IslamHUFE/ECG/circuits/ECG R-puls detector circuit.pdf

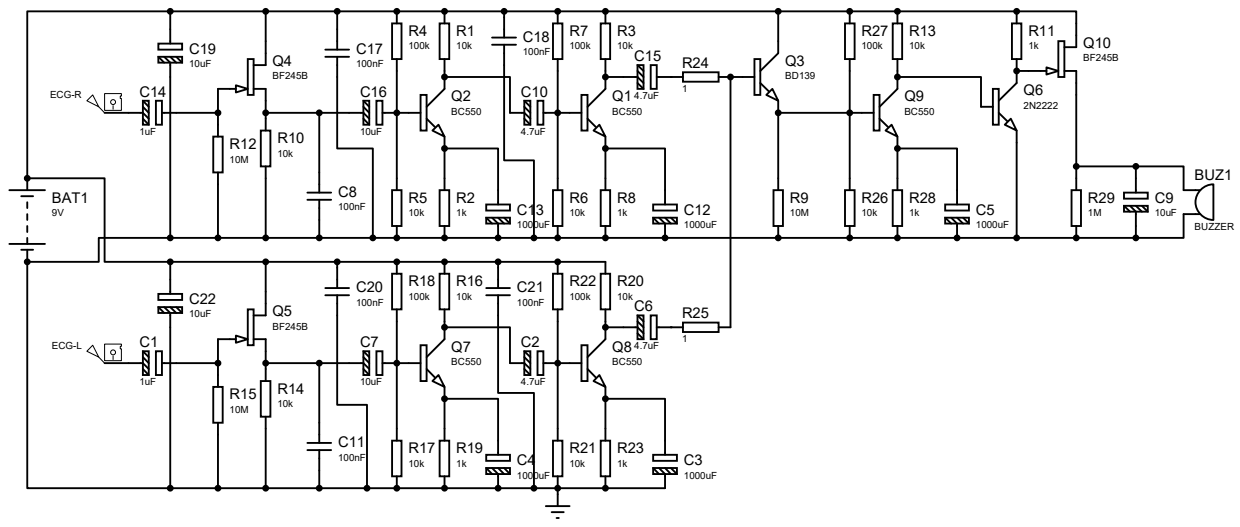
[picture p8: page 1]
