IslamHUFE/ECG/circuits/ECG R-pulse detector circuit 2.pdf

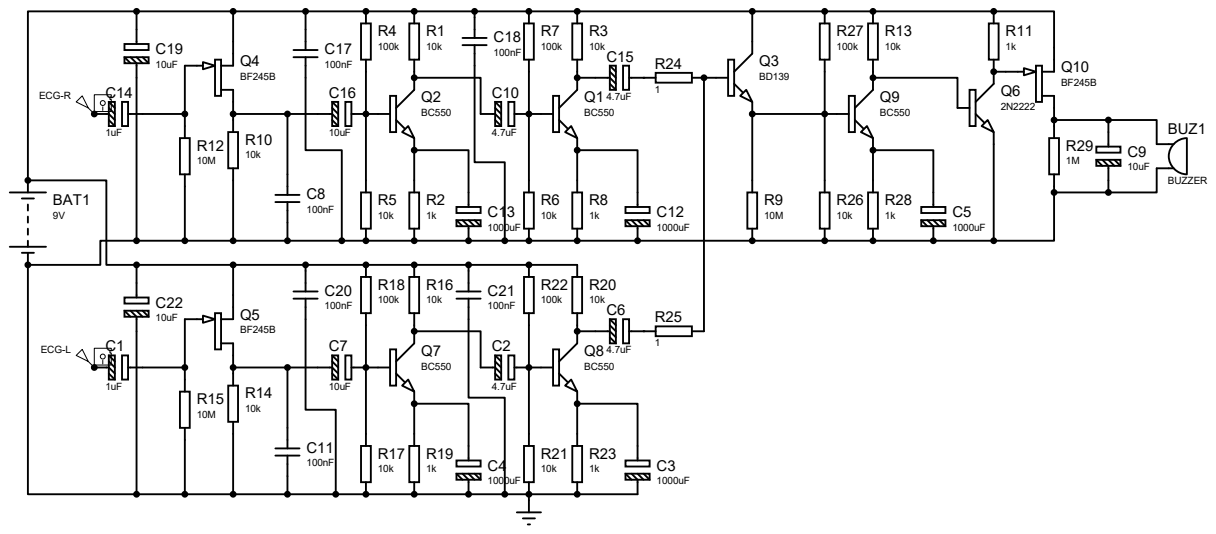
[picture p9: page 1]
