IslamHUFE/ECG/circuits/ؤهقؤعهف.pdf

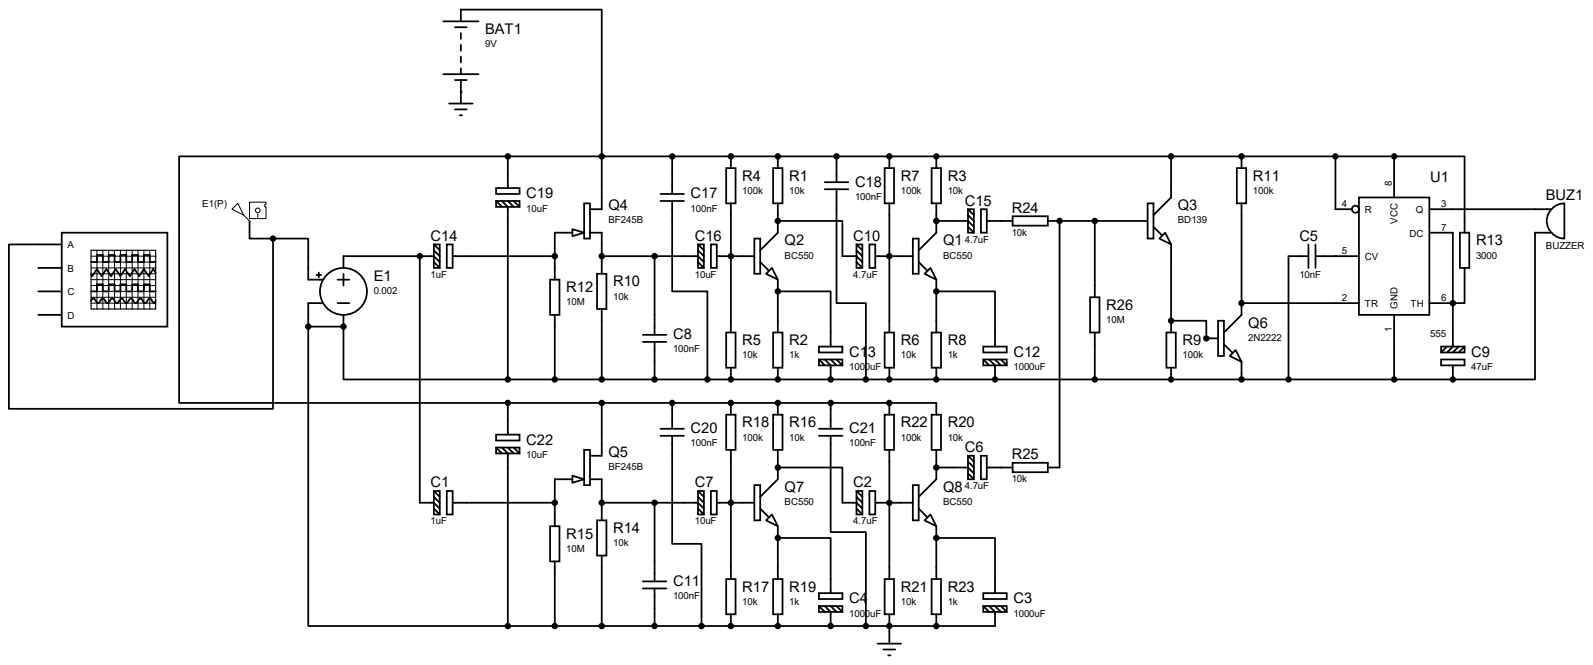
[picture p10: page 1]
