IslamHUFE/ECG/DATA/Freq 1.PDF

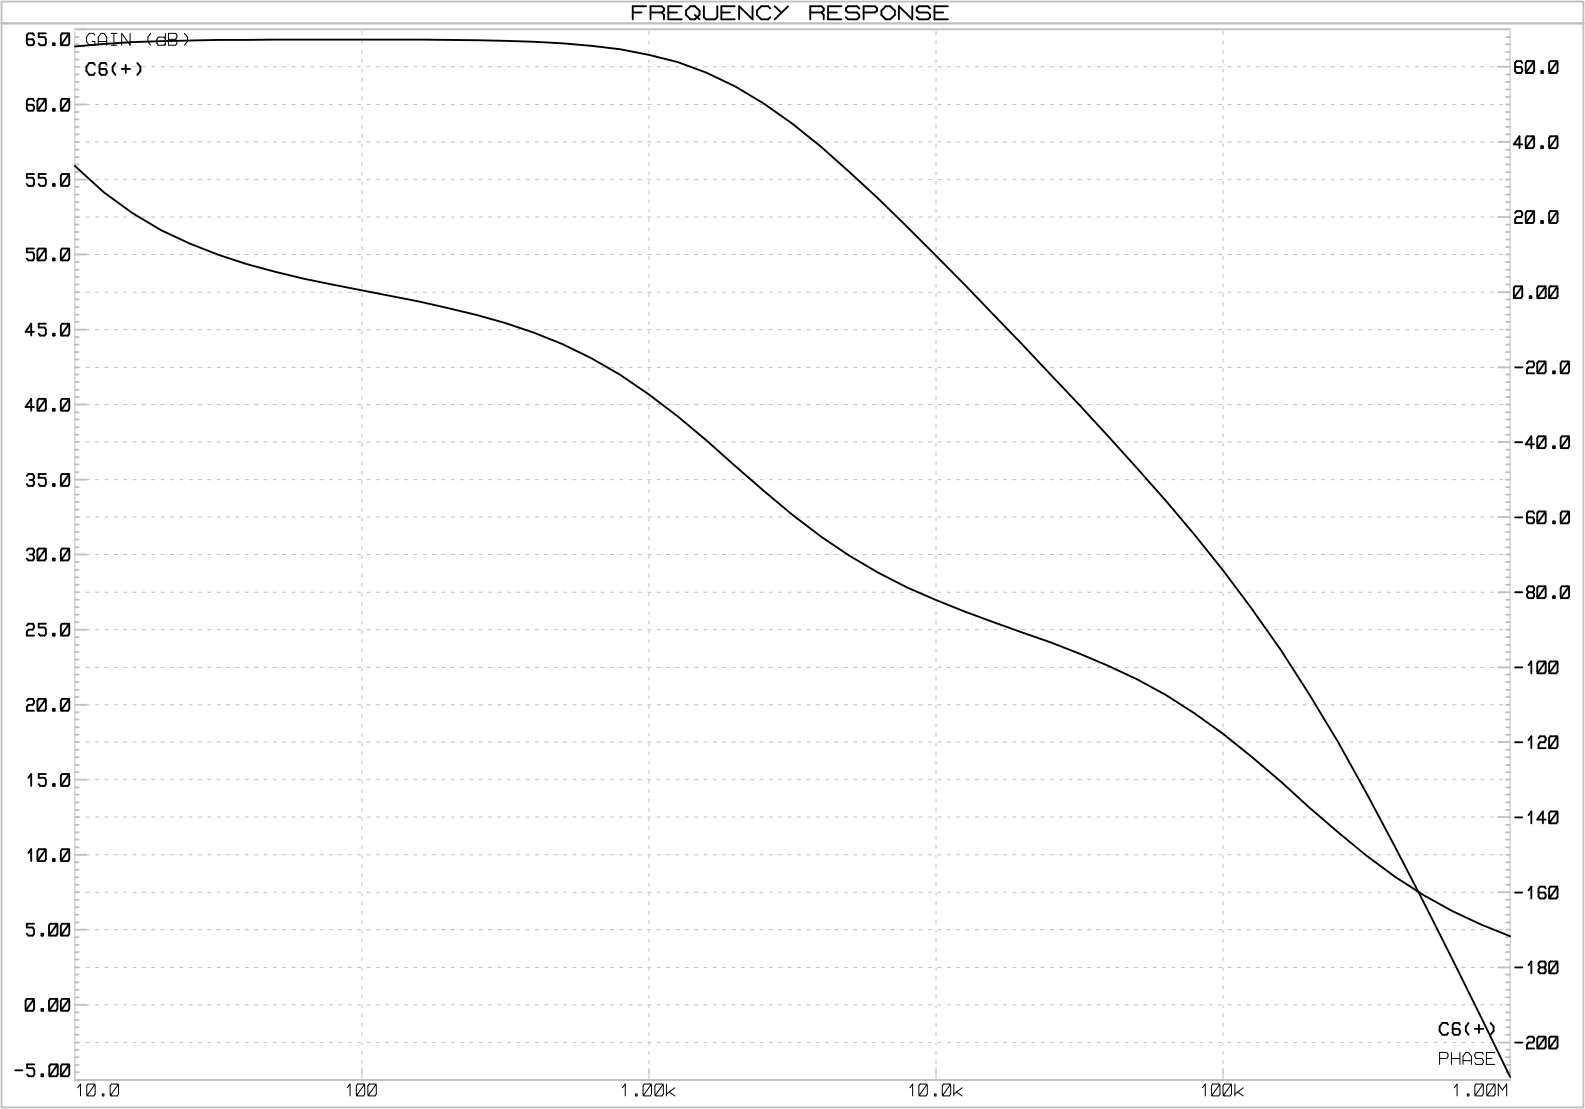
[picture p11: page 1]
