IslamHUFE/ECG/(list of files, drawings)

Other design files:
New Project.pdsprj
Project Backups/New Project [20250501, 17-03-37].pdsprj
Project Backups/New Project [20250501, 20-30-44].pdsprj
Project Backups/New Project [20250503, 14-30-35].pdsprj
Project Backups/New Project [20250503, 20-34-49].pdsprj
Project Backups/New Project [20250505, 15-32-45].pdsprj
Project Backups/New Project [20250508, 12-51-05].pdsprj
Project Backups/New Project [20250510, 16-26-51].pdsprj
Project Backups/New Project [20250511, 13-52-49].pdsprj
Project Backups/New Project [20250511, 18-24-31].pdsprj
Project Backups/New Project [20250513, 14-22-49].pdsprj
