IslamHUFE/ECG/KiCAD/ROV-.kicad_pcb

## KiCad design KiCAD/ROV-.kicad_pcb (2026-05-22)

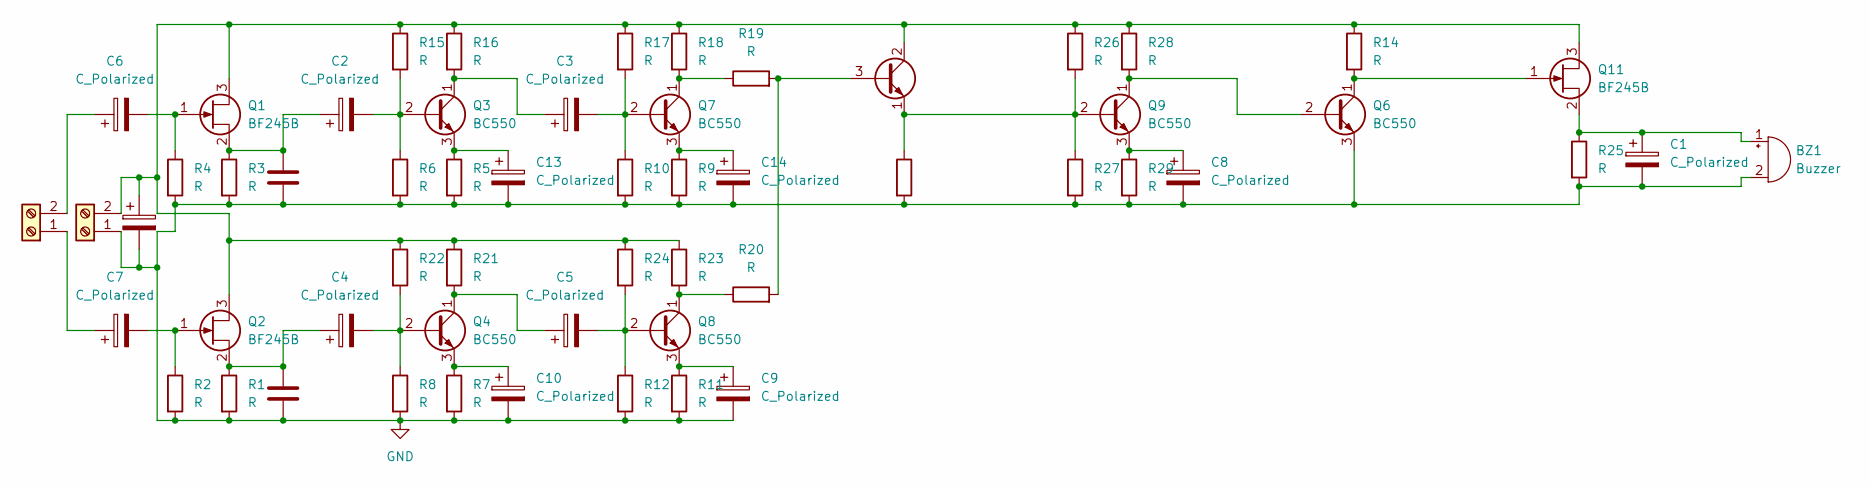
[picture p12: schematic ROV-.kicad_sch]

Parts:
BZ1: Buzzer; Buzzer_TDK_PS1240P02BT_D12.2mm_H6.5mm
C1, C2, C3, C4, C5, C6, C7, C8, C9, C10, C13, C14, C15: C_Polarized; CP_Radial_D5.0mm_P2.50mm
C11, C12: C; C_Disc_D3.0mm_W1.6mm_P2.50mm
J1, J2: Screw_Terminal_01x02; TerminalBlock_MaiXu_MX126-5.0-02P_1x02_P5.00mm
Q1, Q2, Q11: BF245B; TO-92_Inline
Q3, Q4, Q6, Q7, Q8, Q9: BC550; TO-92_Inline
Q5: BD139; TO-126-3_Vertical
R1, R2, R3, R4, R5, R6, R7, R8, R9, R10, R11, R12, R13, R14, R15, R16, R17, R18, R19, R20, R21, R22, R23, R24, R25, R26, R27, R28, R29: R; R_Axial_DIN0204_L3.6mm_D1.6mm_P5.08mm_Horizontal

Connections:
GND: BZ1.2 (-), C1.2, C8.2, C9.2, C10.2, C11.2, C12.2, C13.2, C14.2, C15.2, J1.1, Q6.3 (E), R1.2, R2.2, R3.2, R4.2, R5.2, R6.2, R7.2, R8.2, R9.2, R10.2, R11.2, R12.2, R13.2, R25.2, R27.2, R29.2
unnamed: BZ1.1 (+), C1.1, Q11.2 (S), R25.1
unnamed: C15.1, J1.2, Q1.3 (D), Q2.3 (D), Q5.2 (C), Q11.3 (D), R14.1, R15.1, R16.1, R17.1, R18.1, R21.1, R22.1, R23.1, R24.1, R26.1, R28.1
unnamed: C7.1, J2.1
unnamed: C6.1, J2.2
unnamed: C6.2, Q1.1 (G), R4.1
unnamed: C2.1, C12.1, Q1.2 (S), R3.1
unnamed: C7.2, Q2.1 (G), R2.1
unnamed: C4.1, C11.1, Q2.2 (S), R1.1
unnamed: C2.2, Q3.2 (B), R6.1, R15.2
unnamed: C3.1, Q3.1 (C), R16.2
unnamed: C13.1, Q3.3 (E), R5.1
unnamed: C4.2, Q4.2 (B), R8.1, R22.2
unnamed: C5.1, Q4.1 (C), R21.2
unnamed: C10.1, Q4.3 (E), R7.1
unnamed: Q5.3 (B), R19.2, R20.2
unnamed: Q5.1 (E), Q9.2 (B), R13.1, R26.2, R27.1
unnamed: Q6.2 (B), Q9.1 (C), R28.2
unnamed: C3.2, Q7.2 (B), R10.1, R17.2
unnamed: Q7.1 (C), R18.2, R19.1
unnamed: C14.1, Q7.3 (E), R9.1
unnamed: C5.2, Q8.2 (B), R12.1, R24.2
unnamed: Q8.1 (C), R20.1, R23.2
unnamed: C9.1, Q8.3 (E), R11.1
unnamed: C8.1, Q9.3 (E), R29.1
unnamed: Q6.1 (C), Q11.1 (G), R14.2

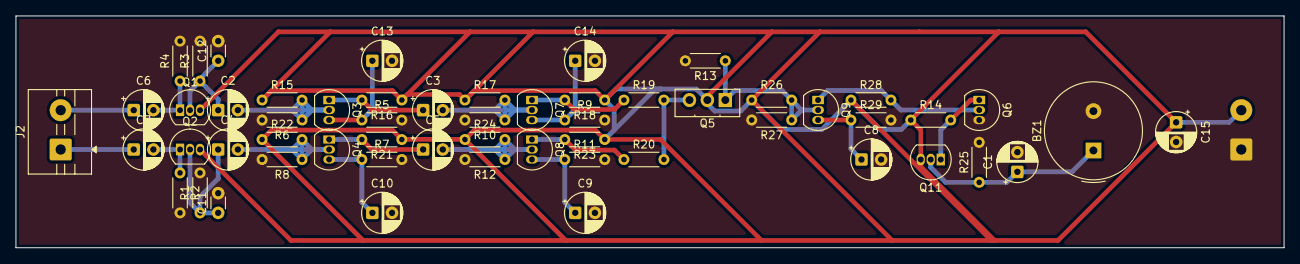
[picture p13: board ROV-.kicad_pcb from above]

Board: 2 copper layers, 161.2 x 29.5 mm, 57 parts (1 on the bottom side), 26 nets.
